juppeee/bobcat-tail-light-pcb/README.md

# Tail Light PCB for the AN3DRC Skid Steer Loader

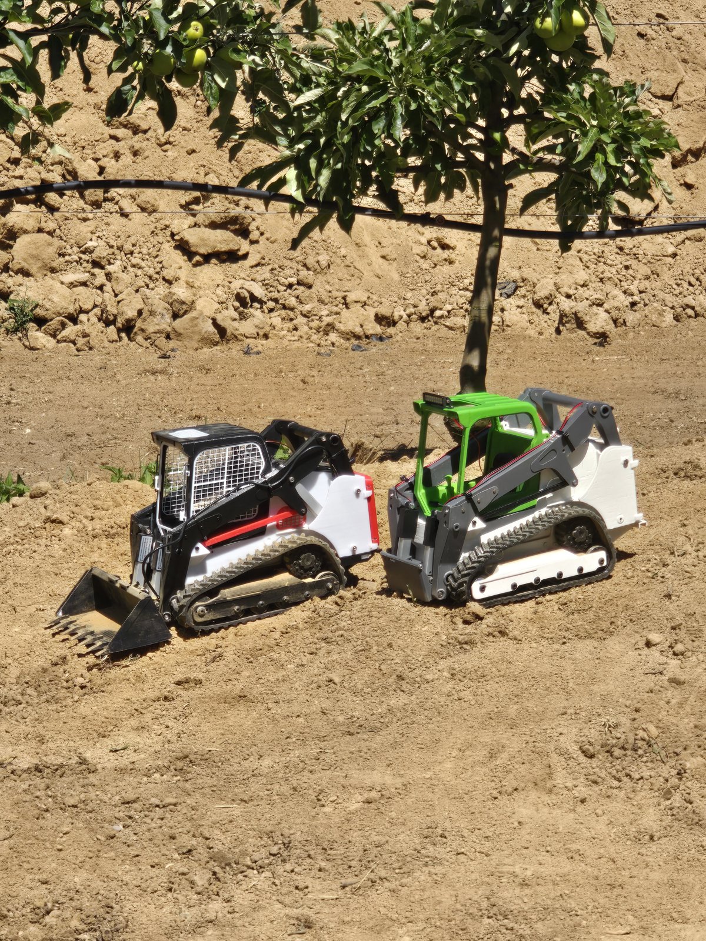
[picture p1: Images/Skid_Steer_Loaders.jpg]
Two AN3DRC skid steer loaders


PCB for working tail, brake and reverse lights in the tailgate of the
AN3DRC 3D-printed RC Tracked Skid Steer Loader.

> **The skid steer loader is not my design.** The original model, including the tailgate and
> the light module sketch, is by **Andrew (AN3DRC)**. You need his model to build this:
> **[buy it on Cults3D](https://cults3d.com/de/modell-3d/spiel/3d-printed-rc-tracked-skid-steer-loader-in-1-8-5-scale-by-an3drc-an3drc_construction)**.
> This repo only adds the tail light PCB.

> [!TIP]
> **Where to get the board:** I ordered mine from **[JLCPCB](https://jlcpcb.com)**. It worked
> very well and wasn't expensive. Upload the Gerber ZIP from the
> [release](../../releases/latest) and keep the default settings, that's it.
> Any other PCB maker works too, see [How to order](#how-to-order).

**Print files (tailgate frame, bezel, LED housings, lenses) and assembly: [MakerWorld](https://makerworld.com/de/collections/37654355-bobcat-an3drc-skid-steer)**

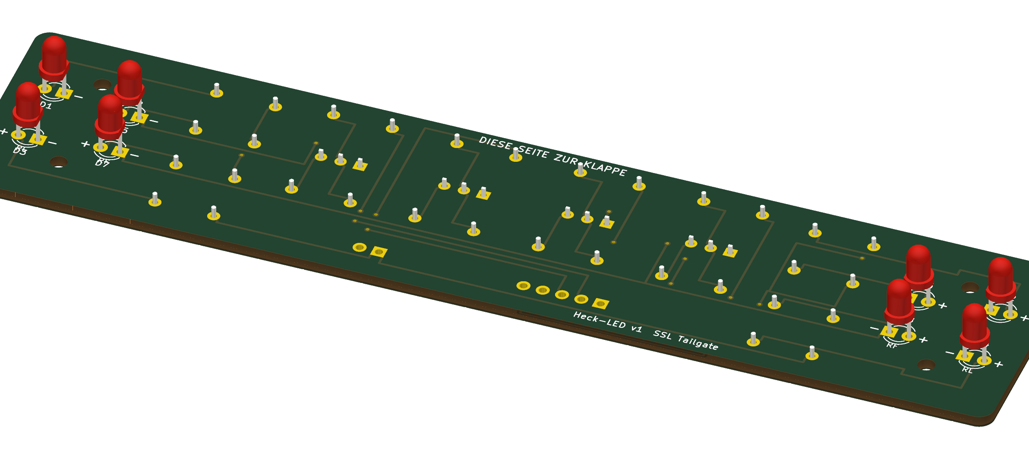
[picture p2: Images/THT_angled_LEDs.png]
PCB, LED side


**[View the assembled PCB in 3D](3D/Tail_Light_PCB_THT.stl)** (GitHub shows an interactive viewer: rotate, zoom)

Board: 134 × 30 mm, 2 layers, 1.6 mm. 8 LEDs (3 mm) on the front facing the tailgate, all
other parts on the back. 4 mounting holes 2.2 mm (M2 or 2.2 mm self-tapping screws, max. 5 mm long).
Driven by a Pro Micro: 4 channels, each pin HIGH switches its two LEDs on through a low-side
MOSFET. The LEDs run from the 12 V battery (3S LiPo).

## Download

Ready-to-upload Gerber ZIPs are attached to the [latest release](../../releases/latest).

## How to order

Any PCB maker works (JLCPCB, PCBWay, Aisler, Elecrow, ...). Pick the one you like, prices
differ more by shipping than by the board.

**1. Board only (THT or SMD version)**
1. Download the Gerber ZIP of your version from the [release](../../releases/latest):
   `Heck_LED_THT_Gerber.zip` or `Heck_LED_SMD_Gerber.zip`.
2. Upload the ZIP **as it is**. Don't unpack it, the maker reads the outline, size and layers from it.
3. Settings: keep the defaults. If asked:

   | Option | Value |
   |---|---|
   | Layers | 2 |
   | Thickness | 1.6 mm |
   | Material | FR-4 |
   | Copper | 1 oz |
   | Surface finish | HASL (lead-free if you prefer), ENIG also fine |
   | Solder mask / silkscreen color | any |
   | Quantity | the minimum (usually 5), one board per tailgate |

   Some makers print an order number on the board. You can usually remove it for a small fee or leave it, it's on the back.
4. Solder the parts yourself (see [Parts per tailgate](#parts-per-tailgate) and `BOM.csv`).

**2. Board with SMD parts already assembled (SMD version only)**

Order like above, then switch on the maker's assembly service ("PCB Assembly", "SMT", ...) and upload two more files from `2_SMD_factory_assembled`:

| File | What the maker calls it |
|---|---|
| `JLCPCB_BOM.csv` | BOM / bill of materials. Columns: value, designators, footprint, LCSC part number |
| `JLCPCB_CPL.csv` (JLCPCB) or `pick_and_place_generic.csv` (others) | CPL / centroid / pick and place / position file |

- Assembly side: **Bottom**. All SMD parts sit on the back, the LEDs are on the front.
- In the preview, check that the four SOT-23 MOSFETs (Q1–Q4) sit with their three pins on the three pads. If they're rotated, turn them in the preview tool.
- The LCSC numbers match JLCPCB's parts library. With other makers, use them to look up the part (value + package is all that matters: 0603 resistors 1 %, 2N7002 in SOT-23).
- Afterwards you still solder the 8 LEDs and the 2 connectors by hand.

## Two versions, same circuit and outline

| Folder | Version |
|---|---|
| [`1_THT_hand_soldered`](1_THT_hand_soldered) | Through-hole, solder it yourself. Upload `Heck_LED_THT_Gerber.zip` unchanged to any PCB maker (JLCPCB, PCBWay, Aisler, ...), default settings: 2 layers, 1.6 mm. `BOM.csv` = parts list (BS170 in TO-92, 1/4 W resistors). |
| [`2_SMD_factory_assembled`](2_SMD_factory_assembled) | SMD parts on the back, assembled by JLCPCB. Upload `Heck_LED_SMD_Gerber.zip`, enable "PCB Assembly", assembly side **Bottom**, upload `JLCPCB_BOM.csv` and `JLCPCB_CPL.csv` (all parts are basic parts with LCSC numbers). Check the SOT-23 rotation in the preview. `pick_and_place_generic.csv` is for other assembly services. You still hand-solder the 8 LEDs and the 2 connectors. |
| [`3_KiCad_source`](3_KiCad_source) | KiCad 10 projects of both versions. |

`Schematic.pdf` is drawn for the THT version. The SMD version is identical except BS170 → 2N7002 and SMD resistors.

## Channels (left + right side each)

| Channel | Position | Function | LED | Resistor |
|---|---|---|---|---|
| K1 | outer top | tail light | red | 1.5 k |
| K2 | outer bottom | tail light | red | 1.5 k |
| K3 | inner top | brake light | red | 680 |
| K4 | inner bottom | reverse light | white | 1 k |

R9–R12 = gate resistors (1 k), R13–R16 = 100 k pulldowns.

## Connectors

Straight magnetic pogo connectors, 2.5 mm pitch, 0.7 mm pins (e.g. AliExpress "5Pin 2.5mm" / "2Pin 2.5mm").
No 90° types, no 2.8 mm pitch.

- **J1** (5 pins, "PRO MICRO"): GND, K1, K2, K3, K4 (5 V signals)
- **J2** (2 pins, "AKKU 12V"): pin 1 = +, pin 2 = −

Battery minus and Pro Micro GND must be connected.

LED marking: `+` = anode (outer, long leg), `−` = cathode (inner, square pad, flat side).

## Works with the original AN3DRC light module sketch

No extra firmware needed. The board expects one 5 V signal per channel (HIGH = on), which is
exactly what the original AN3DRC sketch outputs:

| Original sketch | Pro Micro pin | PCB |
|---|---|---|
| `light` (light switch channel) | A0 (18) | K1 + K2 (tail lights) |
| `rev1` (both tracks reversing) | 4 | K4 (reverse lights) |
| – | GND | GND |

The original sketch has no brake light. Either leave K3 unconnected, or put it on A0 as well
so the inner red LEDs glow as tail lights too.

**Take the signal directly from the Pro Micro pin**, not from the lamp outputs of the original
light module: those are switched to ground and carry 12 V.

## Parts per tailgate

| Part | Qty |
|---|---|
| LED 3 mm red, high brightness | 6 |
| LED 3 mm white, high brightness | 2 |
| Magnetic pogo connector 5-pin + 2-pin, straight, 2.5 mm | 1 set each |
| Screws M2 × 5 or 2.2 × 4.5 self-tapping | 4 |
| THT only: BS170 (TO-92, **not** 2N7000) | 4 |
| THT only: resistors 1/4 W: 1.5 k ×4, 680 ×2, 1 k ×6, 100 k ×4 | |

DRC: 0 unconnected pads. The remaining warnings are silkscreen overlaps only.

## Questions & help

Stuck somewhere or found a problem? Leave a comment on
[MakerWorld](https://makerworld.com/de/collections/37654355-bobcat-an3drc-skid-steer) or open an
[issue](../../issues) here, and I'll get back to you when I can.

## License

PCB design: [CC BY-NC 4.0](LICENSE). Build it, modify it and share it, as long as you credit
juppeee. **No commercial use**: don't sell boards, kits or assembled parts.

The skid steer loader itself, its tailgate and the light module sketch belong to AN3DRC and
are not covered by this license.
