juppeee/bobcat-tail-light-pcb/Images/SMD_bottom.png

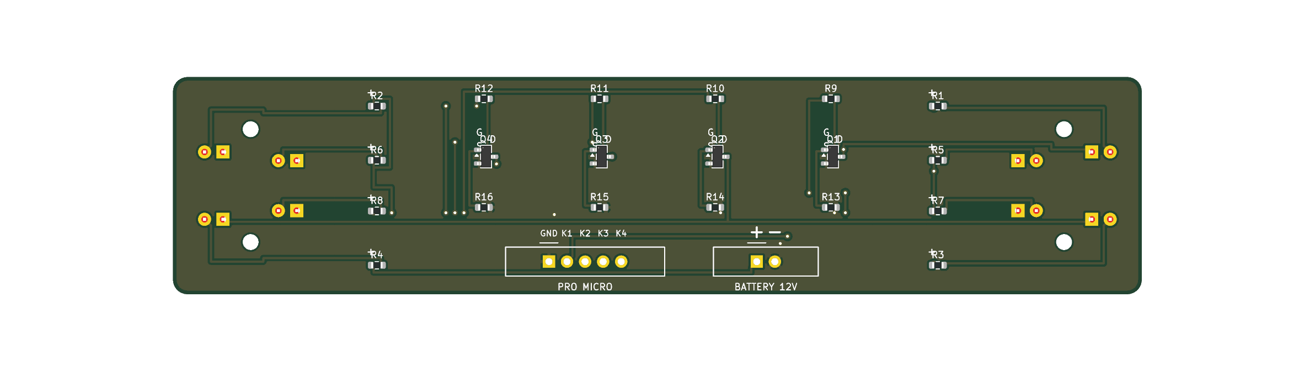
Images/SMD_bottom.png
