juppeee/bobcat-tail-light-pcb/Images/SMD_top_LED_side.png

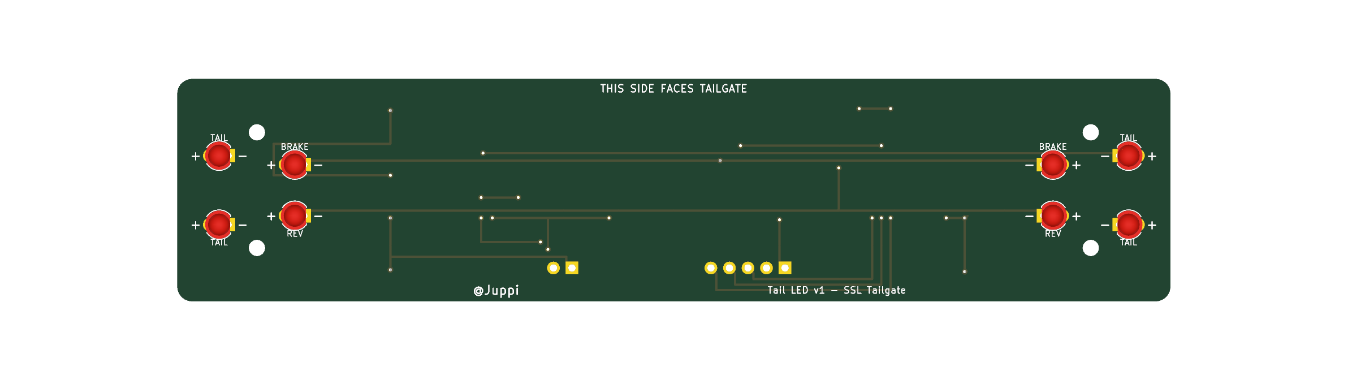
Images/SMD_top_LED_side.png
