juppeee/bobcat-tail-light-pcb/Images/THT_bottom.png

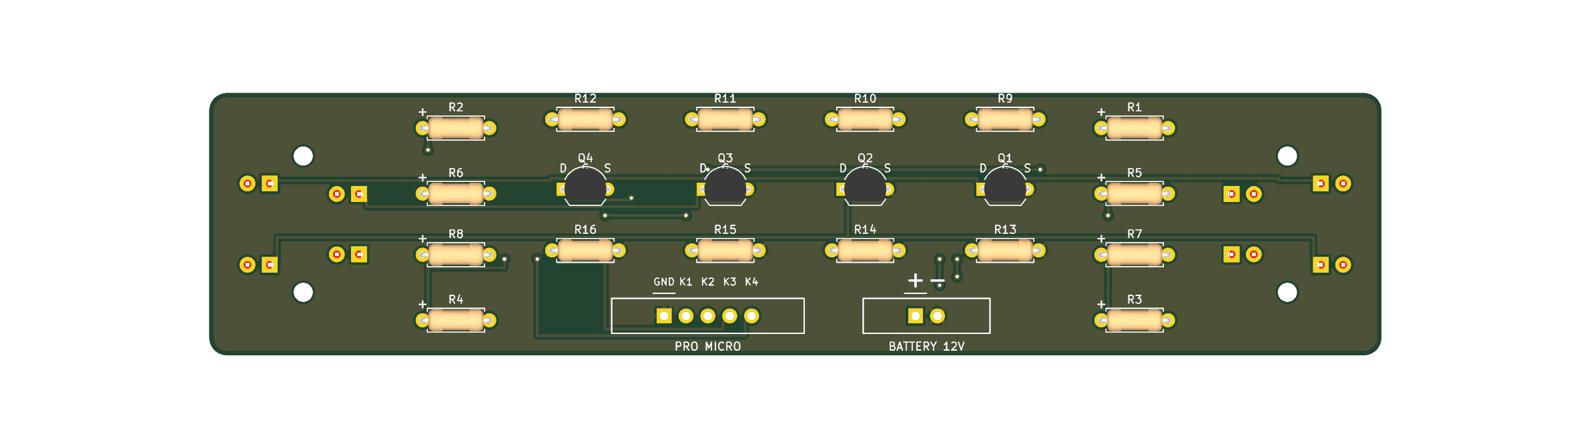
Images/THT_bottom.png
