juppeee/bobcat-tail-light-pcb/Images/THT_top_LED_side.png

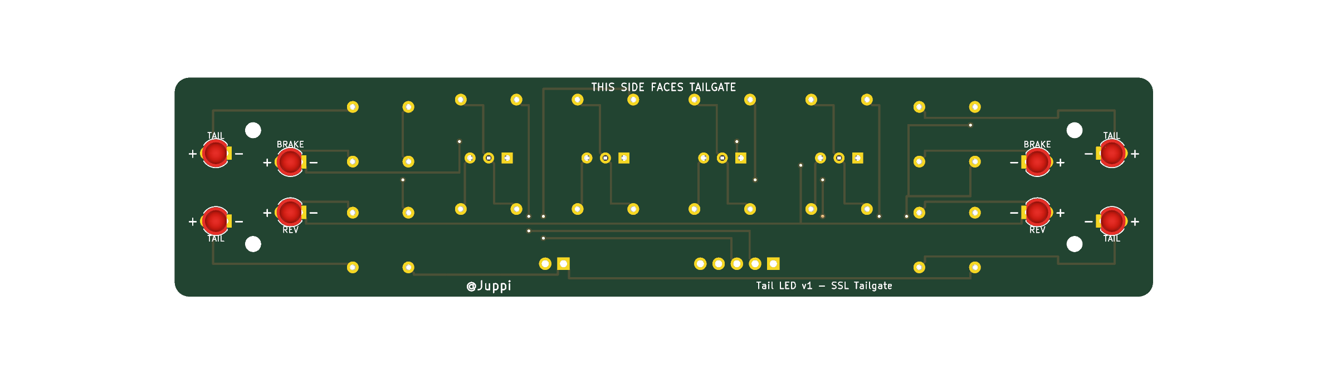
Images/THT_top_LED_side.png
