juppeee/bobcat-tail-light-pcb/1_THT_hand_soldered/BOM.csv

Reference | Value | Footprint
D1-D6 | LED rot | LED_THT:LED_D3.0mm
D7,D8 | LED weiss | LED_THT:LED_D3.0mm
J1 | Pro Micro 5-pol | Heck_LED:MagPogo_1x05_P2.50mm_Straight
J2 | Akku 12V 2-pol | Heck_LED:MagPogo_1x02_P2.50mm_Straight
Q1-Q4 | BS170 | Package_TO_SOT_THT:TO-92_Inline_Wide
R1-R4 | 1.5k | Resistor_THT:R_Axial_DIN0207_L6.3mm_D2.5mm_P7.62mm_Horizontal
R5,R6 | 680 | Resistor_THT:R_Axial_DIN0207_L6.3mm_D2.5mm_P7.62mm_Horizontal
R7-R12 | 1k | Resistor_THT:R_Axial_DIN0207_L6.3mm_D2.5mm_P7.62mm_Horizontal
R13-R16 | 100k | Resistor_THT:R_Axial_DIN0207_L6.3mm_D2.5mm_P7.62mm_Horizontal
