juppeee/bobcat-tail-light-pcb/2_SMD_factory_assembled/JLCPCB_BOM.csv

Comment | Designator | Footprint | LCSC Part #
1.5k | R1,R2,R3,R4 | R_0603_1608Metric | C22843
100k | R13,R14,R15,R16 | R_0603_1608Metric | C25803
1k | R7,R8,R9,R10,R11,R12 | R_0603_1608Metric | C21190
2N7002 | Q1,Q2,Q3,Q4 | SOT-23 | C8545
680 | R5,R6 | R_0603_1608Metric | C23228
