juppeee/bobcat-tail-light-pcb/Images/THT_angled_parts.png

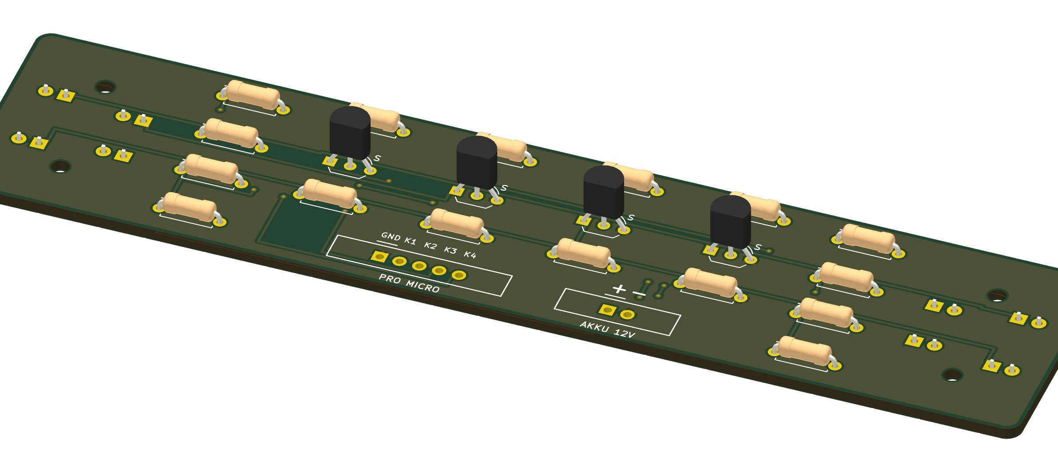
Images/THT_angled_parts.png
