juppeee/bobcat-tail-light-pcb/3D/Tail_Light_PCB_THT.stl

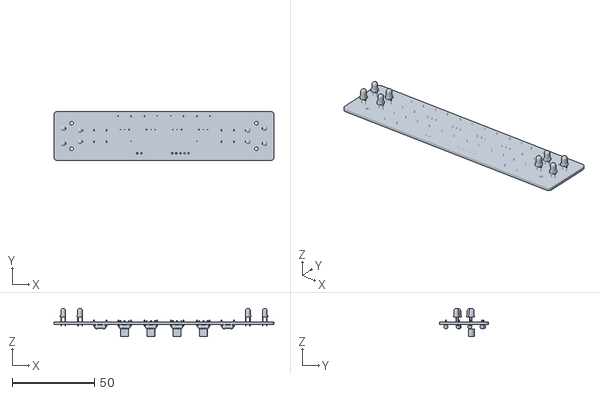
[picture p8: CAD file, 2026-10-29]
3D/Tail_Light_PCB_THT.stl
134.0 x 30.0 x 17.3
