juppeee/bobcat-tail-light-pcb/Schematic.pdf

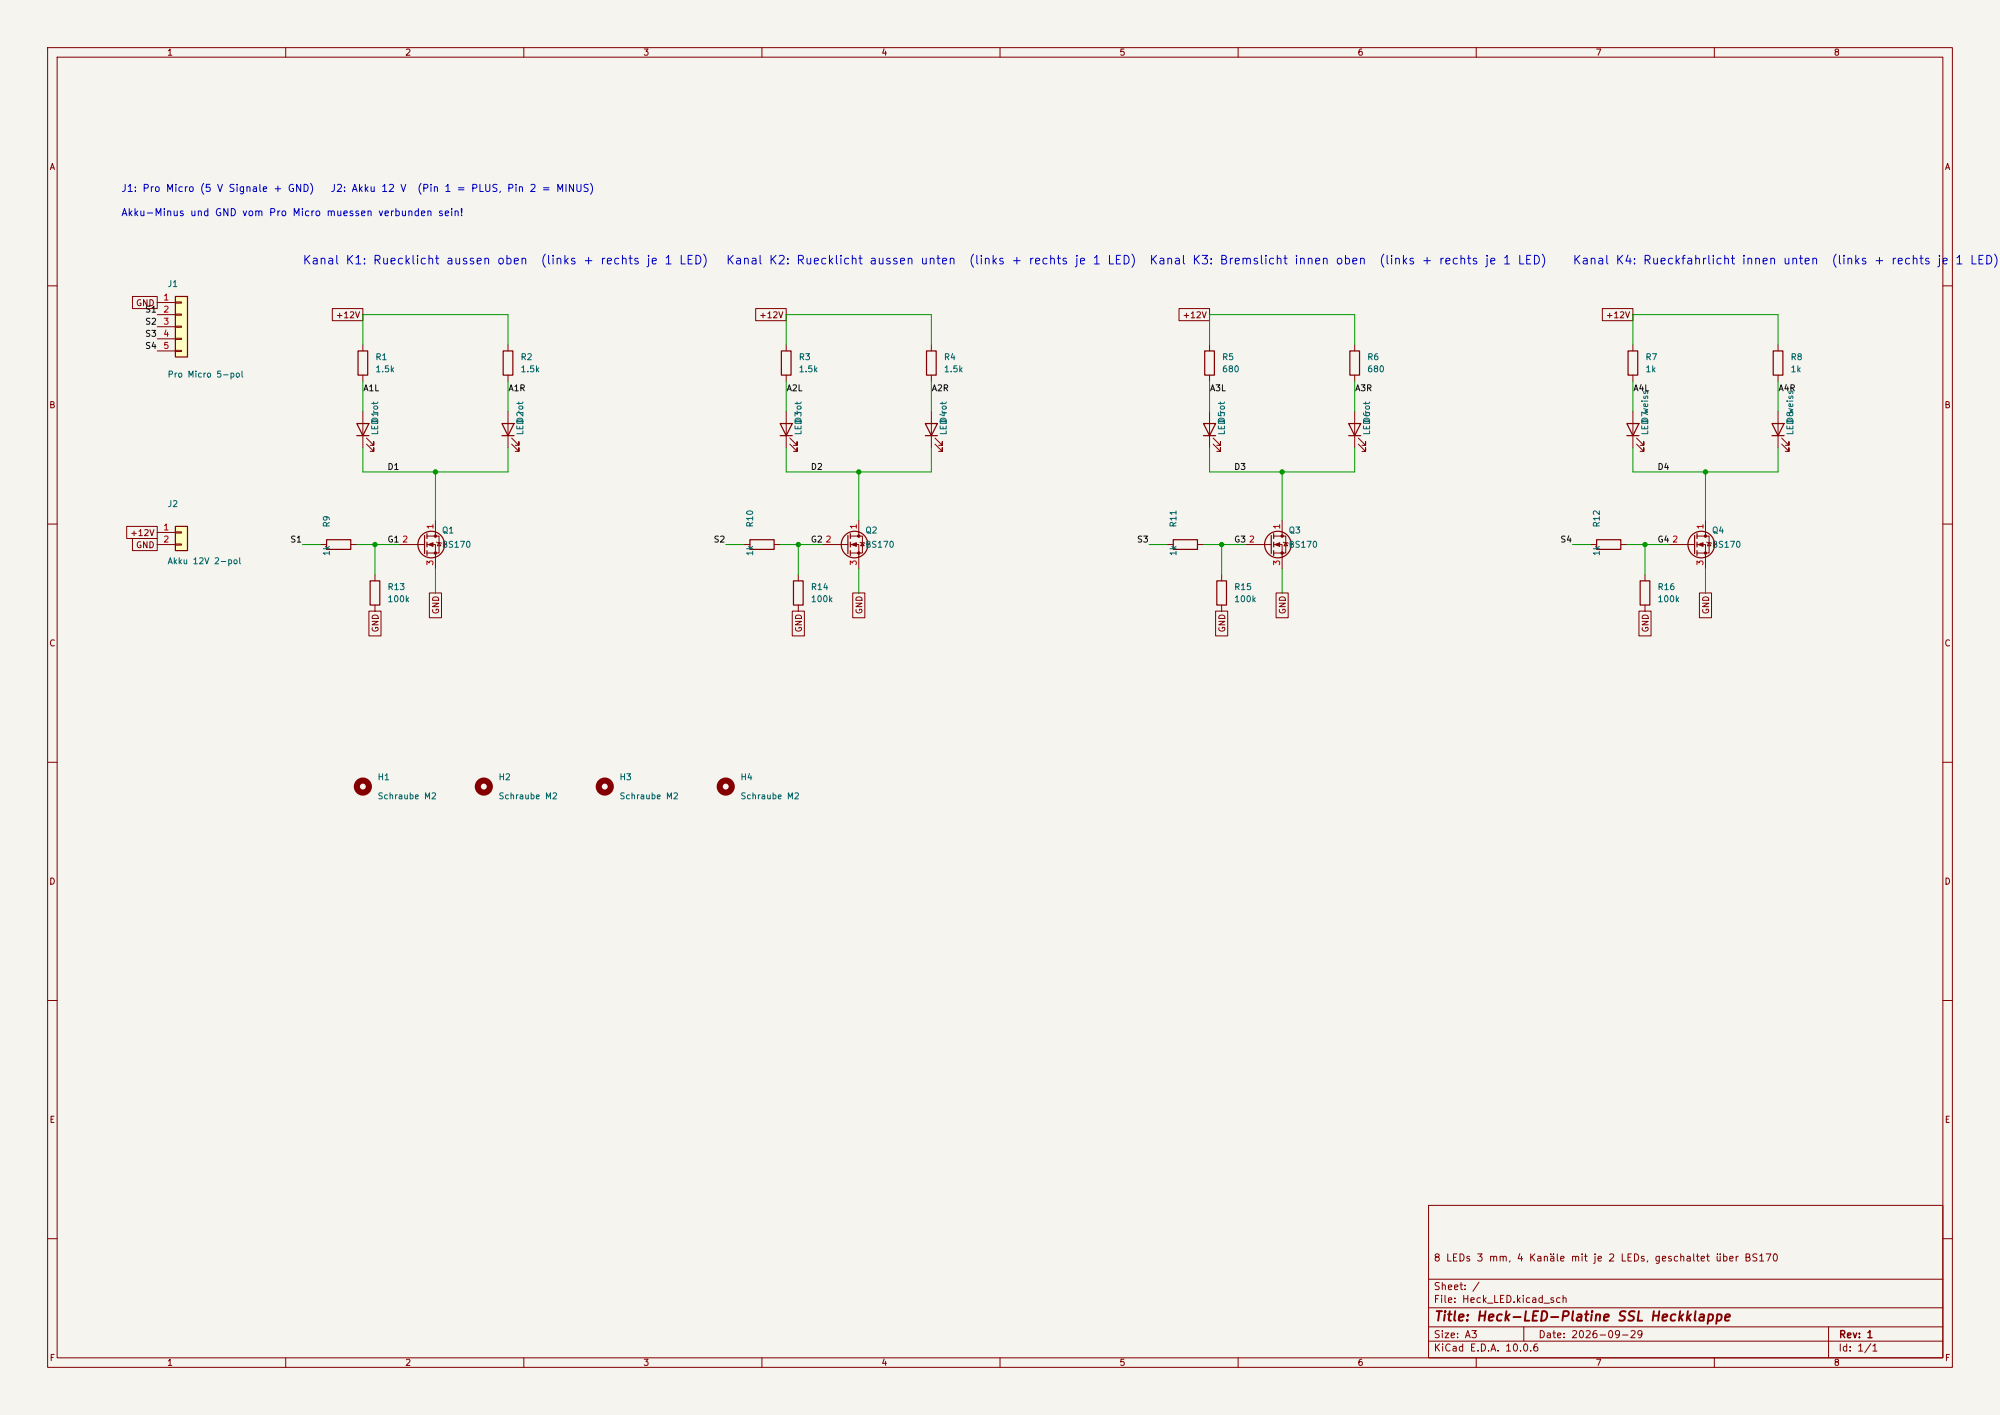
[picture p9: page 1]

Akku-Minus und GND vom Pro Micro muessen verbunden sein!

8 LEDs 3 mm, 4 Kanäle mit je 2 LEDs, geschaltet über BS170

Sheet: /
File: Heck_LED.kicad_sch
Title: Heck-LED-Platine SSL Heckklappe

Size: A3 | Rev: 1 | F Date: 2026-09-29
KiCad E.D.A. 10.0.6 | Id: 1/1
