juppeee/bobcat-tail-light-pcb/3_KiCad_source/THT/Heck_LED.kicad_pcb

## KiCad design 3_KiCad_source/THT/Heck_LED.kicad_pcb (2026-10-29)

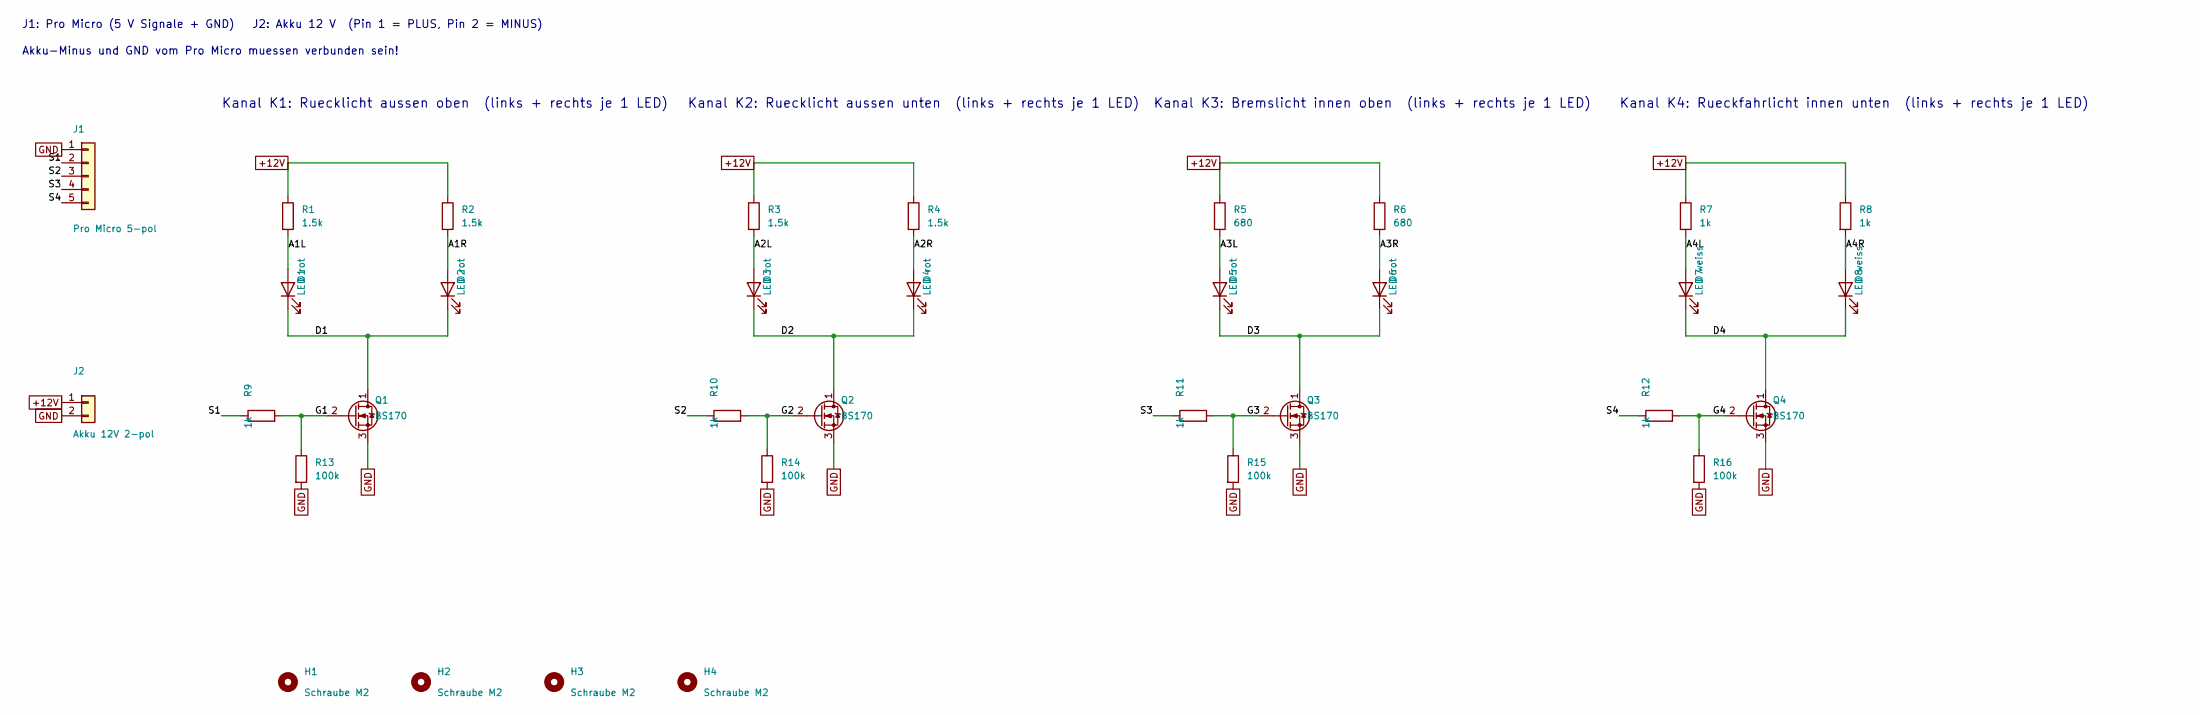
[picture p10: schematic Heck_LED.kicad_sch, Heck-LED-Platine SSL Heckklappe]

Parts:
D1, D2, D3, D4, D5, D6: LED rot; LED_D3.0mm
D7, D8: LED weiss; LED_D3.0mm
H1, H2, H3, H4: Schraube M2; MountingHole_2.2mm_M2
J1: Pro Micro 5-pol; MagPogo_1x05_P2.50mm_Straight
J2: Akku 12V 2-pol; MagPogo_1x02_P2.50mm_Straight
Q1, Q2, Q3, Q4: BS170; TO-92_Inline_Wide
R1, R2, R3, R4: 1.5k; R_Axial_DIN0207_L6.3mm_D2.5mm_P7.62mm_Horizontal
R5, R6: 680; R_Axial_DIN0207_L6.3mm_D2.5mm_P7.62mm_Horizontal
R7, R8, R9, R10, R11, R12: 1k; R_Axial_DIN0207_L6.3mm_D2.5mm_P7.62mm_Horizontal
R13, R14, R15, R16: 100k; R_Axial_DIN0207_L6.3mm_D2.5mm_P7.62mm_Horizontal

Connections:
+12V: J2.1, R1.1, R2.1, R3.1, R4.1, R5.1, R6.1, R7.1, R8.1
/A1L: D1.2 (A), R1.2
/A1R: D2.2 (A), R2.2
/A2L: D3.2 (A), R3.2
/A2R: D4.2 (A), R4.2
/A3L: D5.2 (A), R5.2
/A3R: D6.2 (A), R6.2
/A4L: D7.2 (A), R7.2
/A4R: D8.2 (A), R8.2
/D1: D1.1 (K), D2.1 (K), Q1.1 (D)
/D2: D3.1 (K), D4.1 (K), Q2.1 (D)
/D3: D5.1 (K), D6.1 (K), Q3.1 (D)
/D4: D7.1 (K), D8.1 (K), Q4.1 (D)
/G1: Q1.2 (G), R9.2, R13.1
/G2: Q2.2 (G), R10.2, R14.1
/G3: Q3.2 (G), R11.2, R15.1
/G4: Q4.2 (G), R12.2, R16.1
/S1: J1.2, R9.1
/S2: J1.3, R10.1
/S3: J1.4, R11.1
/S4: J1.5, R12.1
GND: J1.1, J2.2, Q1.3 (S), Q2.3 (S), Q3.3 (S), Q4.3 (S), R13.2, R14.2, R15.2, R16.2

Notes on the sheet:
Kanal K1: Ruecklicht aussen oben (links + rechts je 1 LED)
Kanal K2: Ruecklicht aussen unten (links + rechts je 1 LED)
Kanal K3: Bremslicht innen oben (links + rechts je 1 LED)
Kanal K4: Rueckfahrlicht innen unten (links + rechts je 1 LED)
J1: Pro Micro (5 V Signale + GND) J2: Akku 12 V (Pin 1 = PLUS, Pin 2 = MINUS)
Akku-Minus und GND vom Pro Micro muessen verbunden sein!

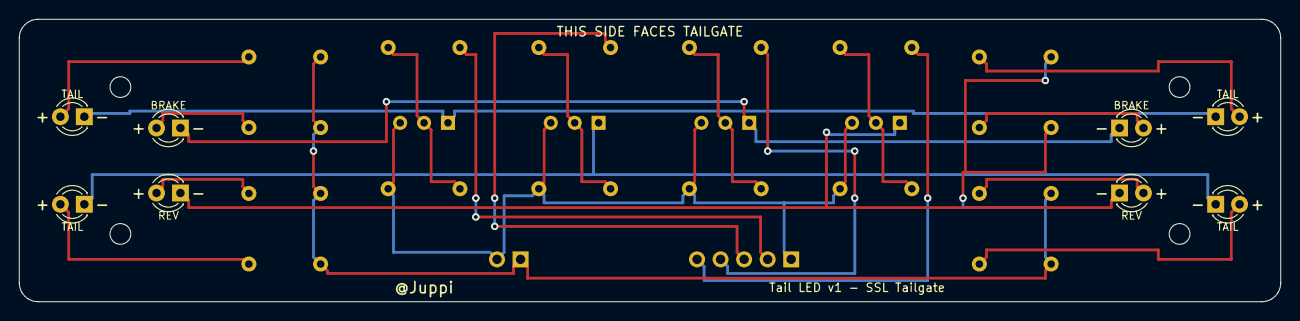
[picture p11: board Heck_LED.kicad_pcb from above]

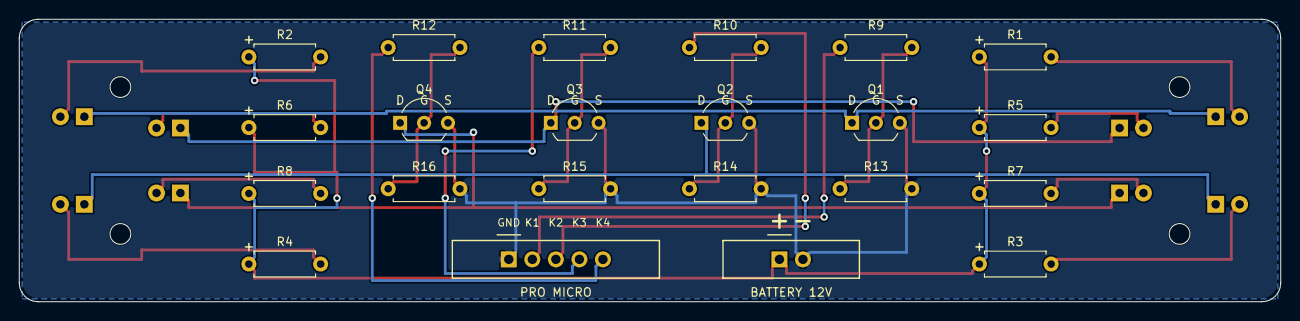
[picture p12: board Heck_LED.kicad_pcb from below]

Board: 2 copper layers, 134.0 x 30.0 mm, 34 parts (22 on the bottom side), 22 nets.
