juppeee/bobcat-tail-light-pcb/(commit log)

2026-10-29 Tail light PCB for the AN3DRC Skid Steer Loader (THT + SMD)
    [BOM.csv, Heck_LED.kicad_pcb, Heck_LED.kicad_sch, JLCPCB_BOM.csv, pick_and_place_generic.csv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]
2026-10-29 Add CC BY 4.0 license and wiring for the original AN3DRC sketch
2026-10-29 Switch to CC BY-NC 4.0, credit AN3DRC, add 3D model of the PCB
    [Tail_Light_PCB_THT.stl]
2026-10-29 Add photo of the skid steer loaders
